jawarr/POV_Display/display.h

// display.h
#ifndef DISPLAY_H
#define DISPLAY_H

#include <stdint.h>
void delayMs(int);
void set_leds(uint8_t);
void input_letter(char);
void display_init(void);
void display_letter(char);

extern volatile uint8_t display_data[5]; 

#endif
