jawarr/POV_Display/(commit log)

2025-11-12 added terminal interface and spi code
2025-11-27 update Final + change to UART
2025-11-28 Uart with word and number implementation
    To send word : word "Hello"
    To send number: number 1
2025-11-30 UART code integrated
2025-11-30 RTC Timer with uart config
2025-11-30 temperature sensing integrated
2025-12-01 Revise instructions in README for clarity
    Updated the instructions for displaying word, temperature, and clock.
2025-12-01 Update instructions for displaying words, temperature, and clock
2025-12-01 add IEEE paper and schematic
2025-12-01 Rename Screenshot 2025-12-01 002045.png to schematic
2025-12-01 Add schematic to README.md
    Updated project description to include 'real time' feature.
2025-12-01 Fix image path in README for schematic
2025-12-01 Rename to schematic.png
